SFBdragon/eee4113f-project/enclosure_subsystem/Media/Images/Sunken_SharcBuoy.JPG

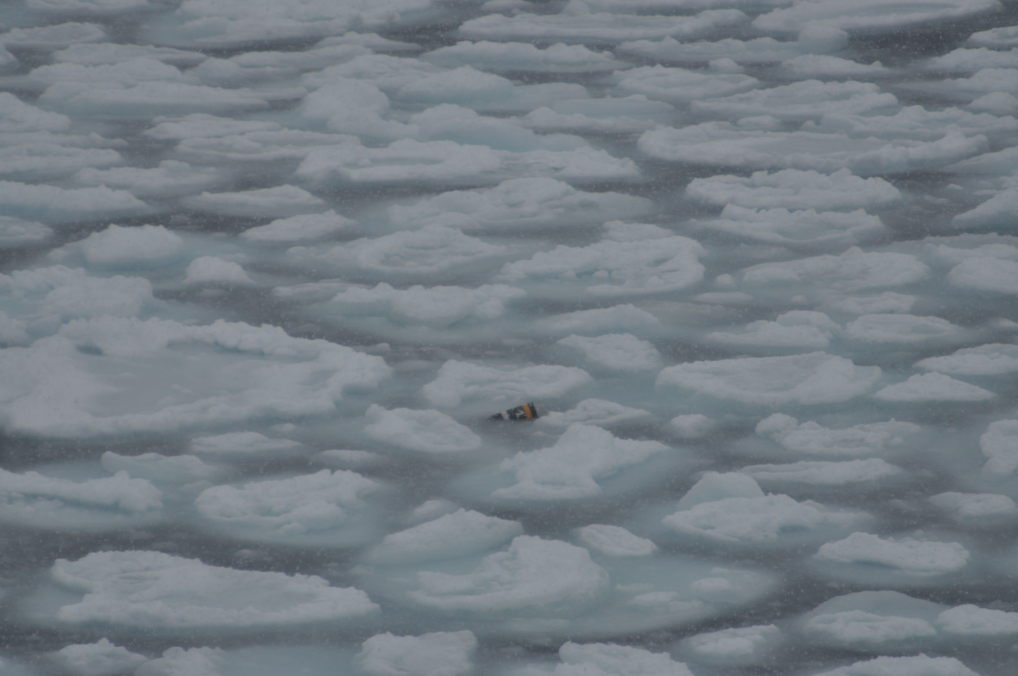
enclosure_subsystem/Media/Images/Sunken_SharcBuoy.JPG
