SFBdragon/eee4113f-project/enclosure_subsystem/Media/Images/20220717_UniversityofGottenburg_sailbuoy_retrival.jpeg

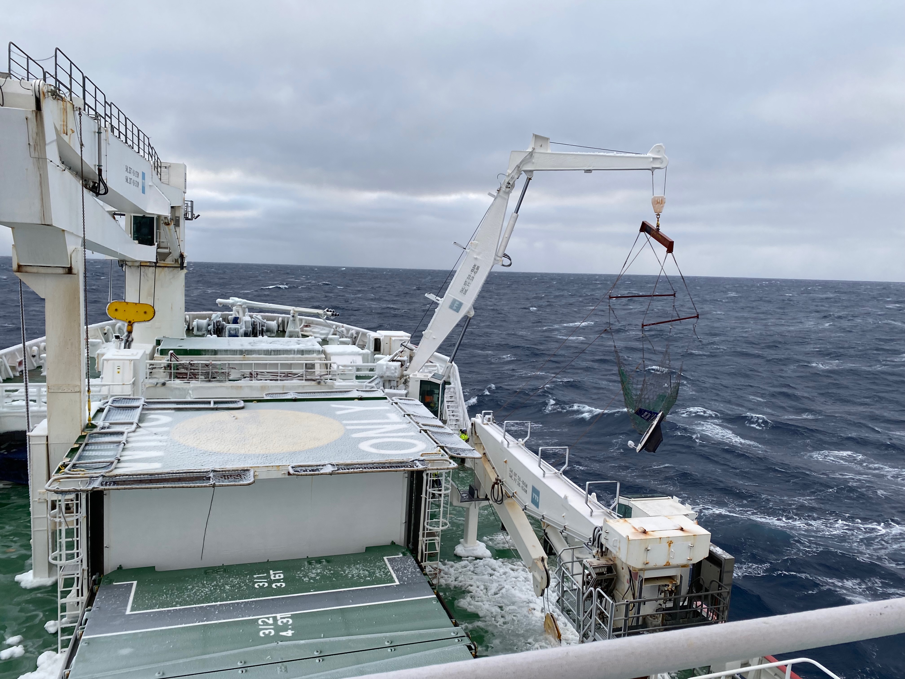
enclosure_subsystem/Media/Images/20220717_UniversityofGottenburg_sailbuoy_retrival.jpeg
