SFBdragon/eee4113f-project/README.md

# EEE4113F Project - Antarctic Measurement System Communication Module

_Group 5_

---

TODO
