SFBdragon/eee4113f-project/enclosure_subsystem/Data_Logs/readme_sb01.md

# SHARC Buoy SB01 Notes

## Buoy Information
| Parameter | Details |
|---|---|
| **Buoy Name** | SB01 |
| **Model** | SHARC Buoy Version 3.0 |
| **Firmware Version** | Version 18 July 2022 |  
| **Sampling rate** | 103 Hz |
| **Sampling interval** | 25 minutes (5*5 minute) |
| **Onboard storage** | Raw inertial time series, time and GNSS data. |
| **Transmission interval**  | ~42 minutes |
| **Transmission packet** | GNSS position, time, excludes wave statistics |
| **Iridium RockBlock Code** | CNH-GUD |
| **Iridium Code (Serial)**  | 205042 |
| **Iridium Code (IMEI)** | 300434061062220 |
| **IMU Number** | TEST (T) IMU |
| **SD Card Number** | SD1 |
---
## Deployment

| Parameter | Value |
|---|---|
| **Station Name** | ICE21 (I1) | 
| **Date** | 2022-07-19 |
| **Station time open (UTC)**  | 12:35 |
| **Station time closed (UTC)**| 16:17 |
| **Time deployed (UTC)** | 13:20 |
| **Coordinates (DD)** | -58.67003, -1.24678 |
| **Coordinates (DMS)** | 58°40'12.11"S, 1°14'48.41"W  |
| **Sounding (m)** | 4216.0 |
| **Humidity (%)** | 86 |
| **Barometer** | 0.9947 |
| **Air Temperature (°C)** | -7.5 |
| **Wind Speed (kn) rel** | 11.3 |
| **Wind Speed (kn) tue** | 12.3 |
| **Wind Direction rel (deg)** | 215 |
| **Wind Direction true (deg)**| 264.5 |

### Deployment Team
- **Member 1:** Michael Noyce
- **Member 2:** Justin Pead
- **Member 3:** Robyn Verrinder
  
### Deployment image
SB01 Deployment on 2022-07-19. Image credit: A Spirakis

### Additional Notes
- Deployed successfully onto consolidated ice with fresh snow layer using personnel basket from front overside crane. Calm conditions
- Ice floe strong enough for standing and buoy stand placed on ice by hand.
- Only SHARC2 GoPro Hero10 camera footage recorded successfully; SHARC1 failed.

---
	
## Retrieval
| Parameter | Value |
|---|---|
| **Station Name:** | SB01 |
| **Date** | 2022-07-24 |
| **Station time open (UTC)**  | 12:08 |
| **Station time closed (UTC)**| 12:30 |
| **Time retrived (UTC)** | 12:25 |
| **Coordinates (DD)** | -59.1141, 0.66428 |
| **Coordinates (DMS)** | 59°6'50.76"S, 0°39'51.41"E |
| **Sounding (m)** | 4730.7 |
| **Humidity (%)** | 84 |
| **Barometer** | 0.958 |
| **Air Temperature (°C)** | -2.2 |
| **Wind Speed (kn) rel** | 13 |
| **Wind Speed (kn) tue** | 12.9 |
| **Wind Direction rel (deg)** | 57.4 |
| **Wind Direction true (deg)**| 318.7 |

### Retrieval Team
- **Member 1:** Michael Noyce
- **Member 2:** Lawrence Stanton
- **Member 3:** Safiyyah Moos

### Retrieval image
SB01 Retrieval on 2022-07-24. Image credit: N Taylor

### Additional Notes
- Ice floe size significantly reduced, melted, and broke apart;
- Buoy stand sank and buoy temporarily submerged during retrieval but collected and data retrieved.
- No camera footage recorded on GoPro Hero10 cameras (SHARC1 and SHARC2).
- Still images of conditions obtained from N Taylor

### Buoy Condition
- Power board disconnected after system disconnected.
- Condensation on exterior of seal and bottom PCB.
- Corrosion observed on power board lead solder pads and Iridium stand solder pads.
- Batteries ignited as they got wet during the retrieval
- **Cause:** AfriSol solder wire is susceptible to corrosion.
- **Battery voltage:** 7.195 V
