SFBdragon/eee4113f-project/enclosure_subsystem/Media/Images/20220720_GoPRO_SHARC2_SB04_deployment.png

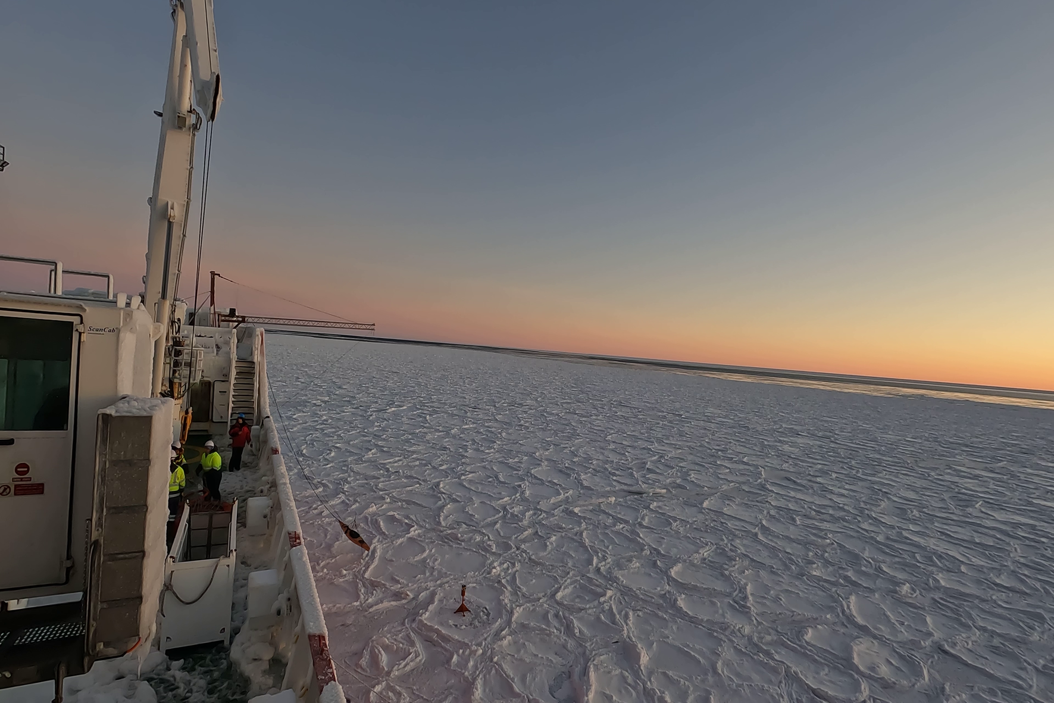
enclosure_subsystem/Media/Images/20220720_GoPRO_SHARC2_SB04_deployment.png
