SFBdragon/eee4113f-project/enclosure_subsystem/Media/Images/20220724_GoPRO_SHARC1_SB04_retrieval.png

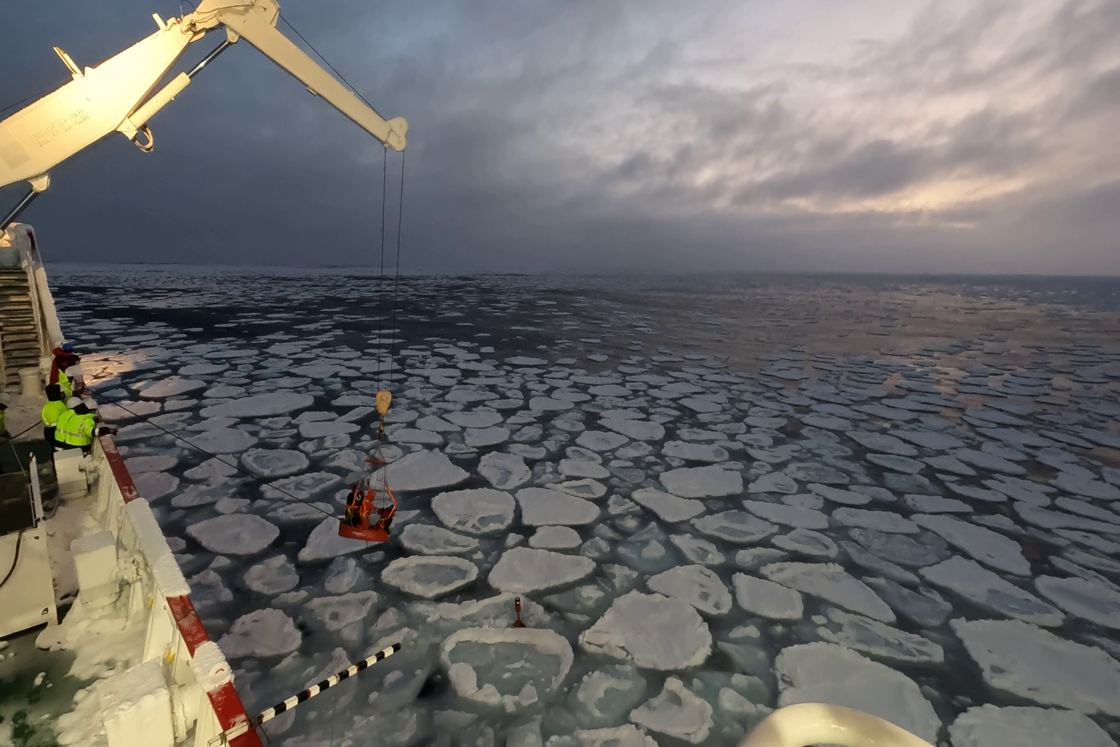
enclosure_subsystem/Media/Images/20220724_GoPRO_SHARC1_SB04_retrieval.png
