SFBdragon/eee4113f-project/enclosure_subsystem/Media/Images/20220724_SB01_02_Taylor_N.JPG

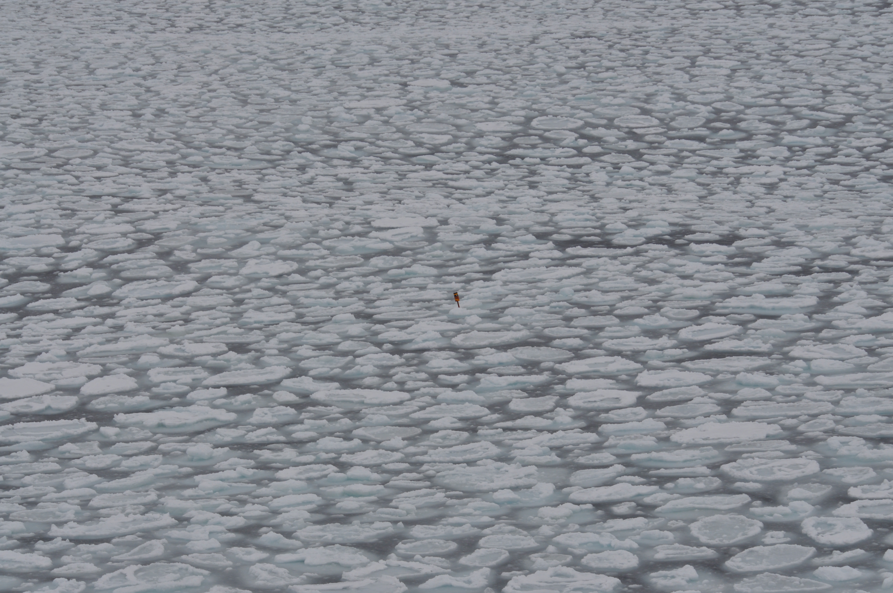
enclosure_subsystem/Media/Images/20220724_SB01_02_Taylor_N.JPG
