SFBdragon/eee4113f-project/enclosure_subsystem/Model_Files/floatation_Ring.stl

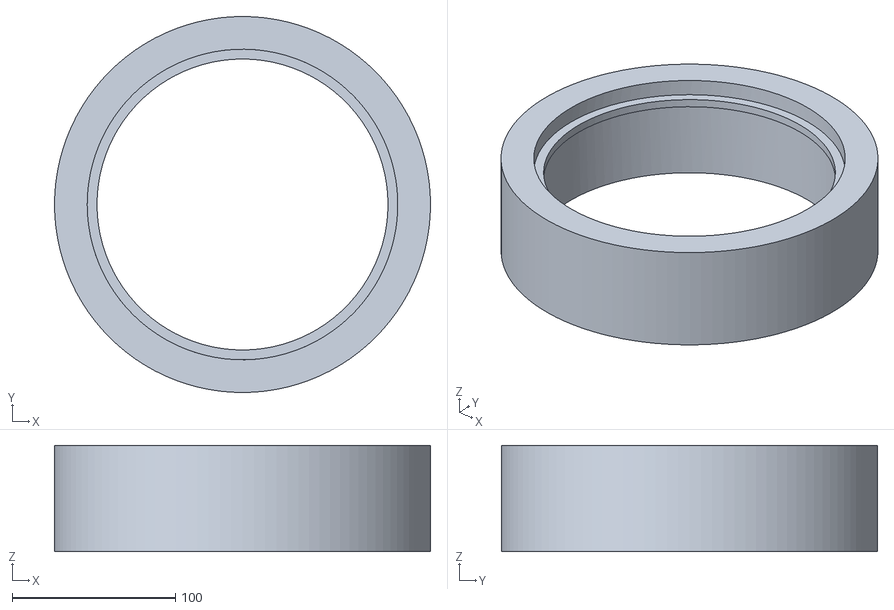
[picture p7: CAD file, 2026-05-19]
enclosure_subsystem/Model_Files/floatation_Ring.stl
230.0 x 230.0 x 65.0
