SFBdragon/eee4113f-project/enclosure_subsystem/Model_Files/ballast_body.stl

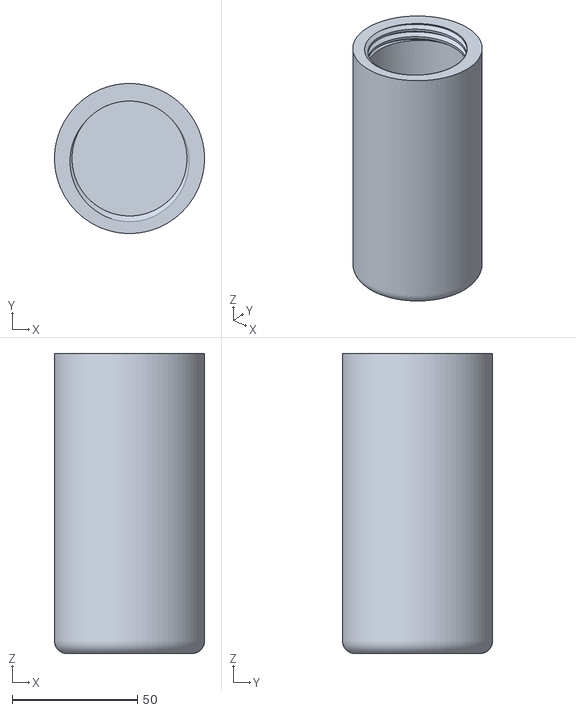
[picture p8: CAD file, 2026-05-19]
enclosure_subsystem/Model_Files/ballast_body.stl
60.0 x 60.0 x 120.0
