SFBdragon/eee4113f-project/enclosure_subsystem/Model_Files/component_holder.stl

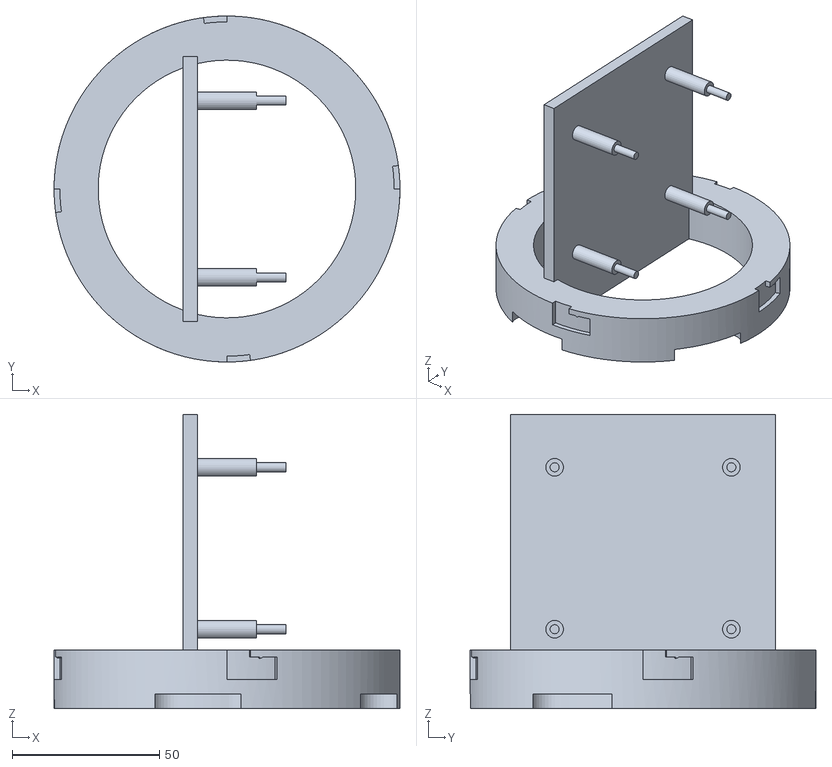
[picture p9: CAD file, 2026-05-19]
enclosure_subsystem/Model_Files/component_holder.stl
117.5 x 117.5 x 100.0
