SFBdragon/eee4113f-project/enclosure_subsystem/Model_Files/connector_pod.stl

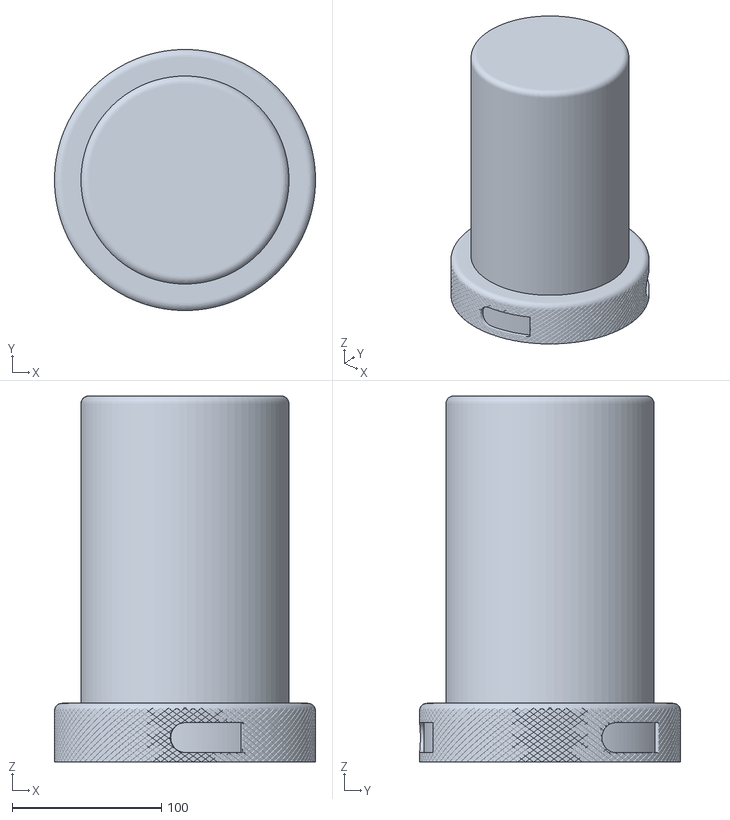
[picture p10: CAD file, 2026-05-19]
enclosure_subsystem/Model_Files/connector_pod.stl
175.0 x 175.0 x 245.4
