SFBdragon/eee4113f-project/enclosure_subsystem/Model_Files/sb_cover.stl

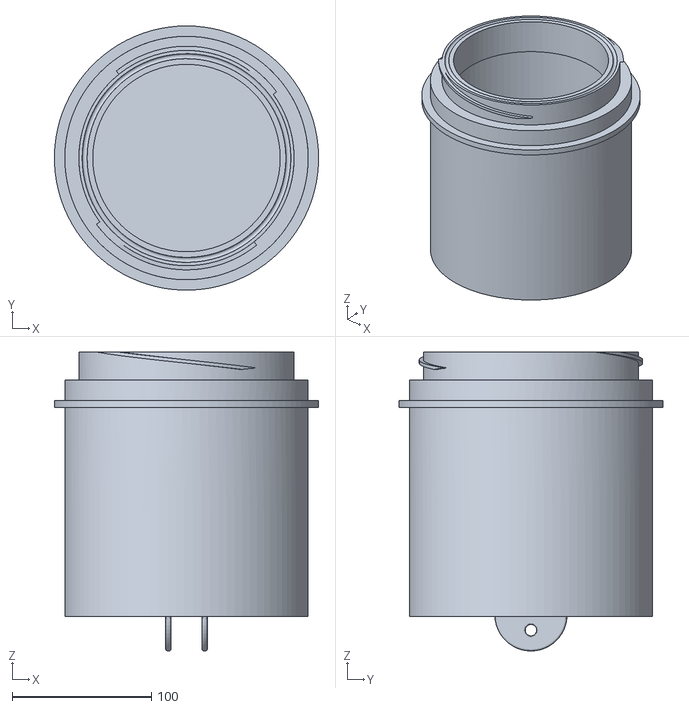
[picture p11: CAD file, 2026-05-19]
enclosure_subsystem/Model_Files/sb_cover.stl
190.0 x 189.9 x 215.0
