SFBdragon/eee4113f-project/enclosure_subsystem/Model_Files/ballast_lid.stl

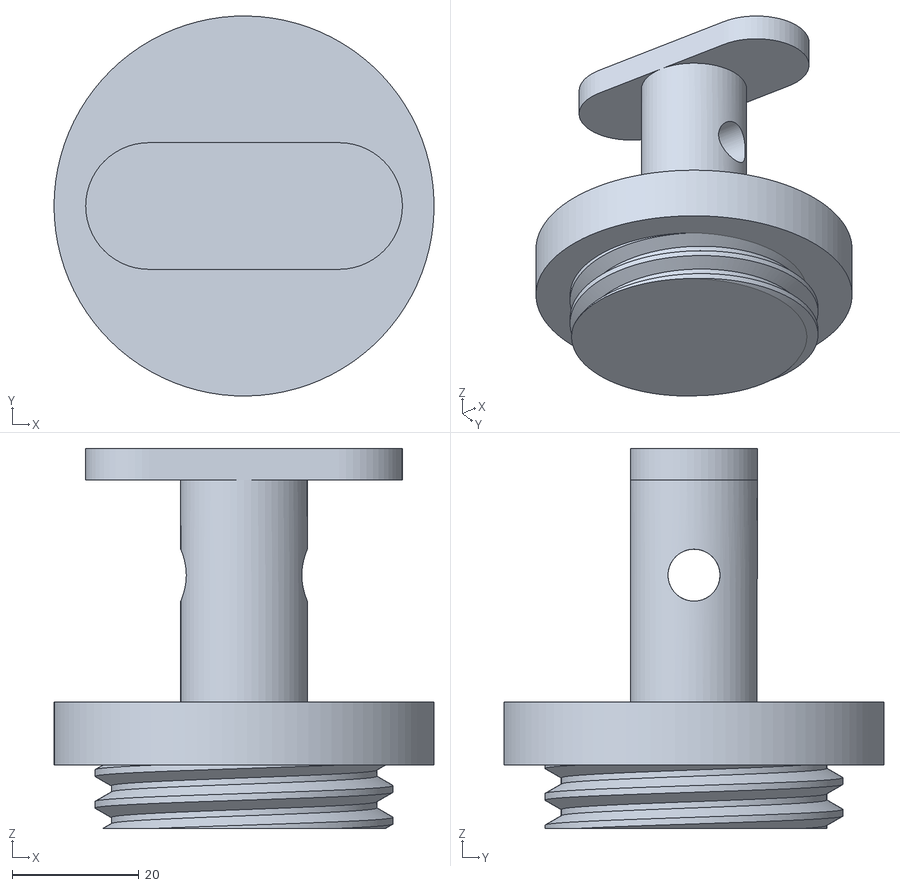
[picture p12: CAD file, 2026-05-19]
enclosure_subsystem/Model_Files/ballast_lid.stl
60.0 x 60.0 x 60.0
