SFBdragon/eee4113f-project/enclosure_subsystem/Model_Files/ballast_nut.stl

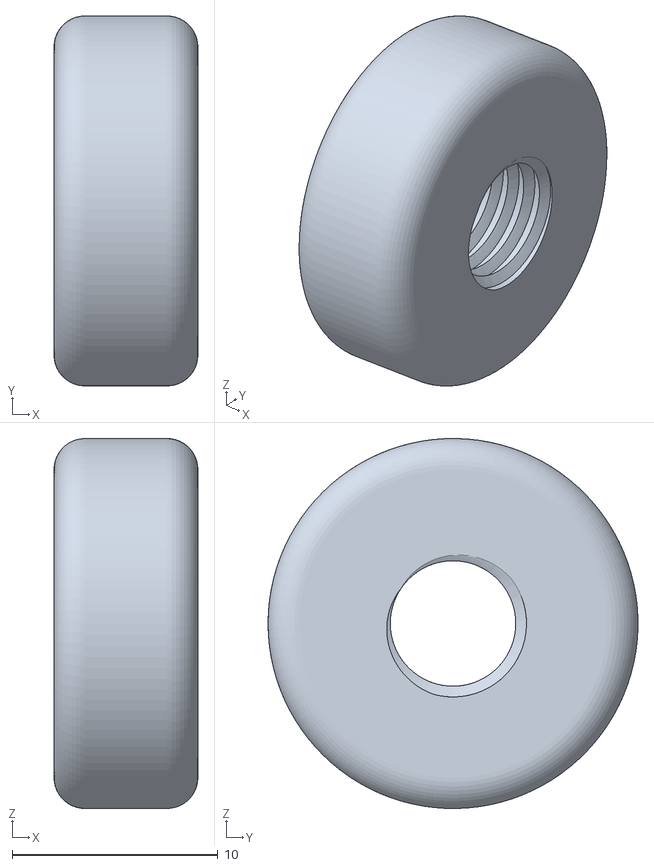
[picture p13: CAD file, 2026-05-19]
enclosure_subsystem/Model_Files/ballast_nut.stl
7.00 x 18.0 x 18.0
