SFBdragon/eee4113f-project/enclosure_subsystem/Model_Files/ballast_screw.stl

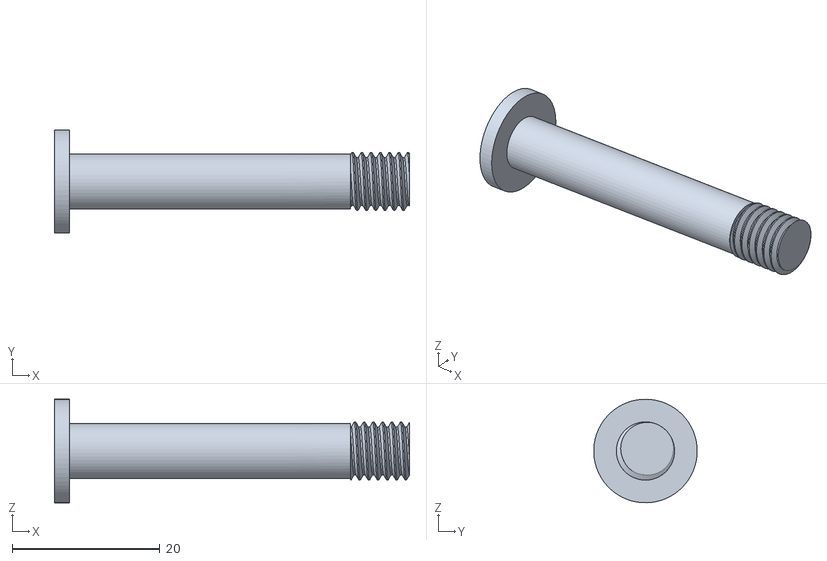
[picture p14: CAD file, 2026-05-19]
enclosure_subsystem/Model_Files/ballast_screw.stl
48.0 x 14.0 x 14.0
