SFBdragon/eee4113f-project/laptop-drivers/RF_ATPs/test100m.csv

timestamp | packet_num | payload | rssi_dbm | snr_db | len_bytes
2026-05-13T14:11:39 | 1 | 1 | -75 | 6 | 1
2026-05-13T14:11:41 | 2 | 2 | -75 | 6 | 1
2026-05-13T14:11:43 | 3 | 3 | -75 | 5 | 1
2026-05-13T14:11:45 | 4 | 4 | -75 | 4 | 1
2026-05-13T14:11:47 | 5 | 5 | -75 | 5 | 1
2026-05-13T14:11:49 | 6 | 6 | -74 | 6 | 1
2026-05-13T14:11:51 | 7 | 7 | -74 | 6 | 1
2026-05-13T14:11:53 | 8 | 8 | -74 | 6 | 1
2026-05-13T14:11:55 | 9 | 9 | -74 | 6 | 1
2026-05-13T14:11:57 | 10 | 10 | -76 | 5 | 2
2026-05-13T14:11:59 | 11 | 11 | -76 | 6 | 2
2026-05-13T14:12:01 | 12 | 12 | -75 | 6 | 2
2026-05-13T14:12:03 | 13 | 13 | -75 | 6 | 2
2026-05-13T14:12:05 | 14 | 14 | -75 | 5 | 2
2026-05-13T14:12:07 | 15 | 15 | -75 | 6 | 2
2026-05-13T14:12:09 | 16 | 16 | -75 | 6 | 2
2026-05-13T14:12:11 | 17 | 17 | -76 | 5 | 2
2026-05-13T14:12:13 | 18 | 18 | -75 | 6 | 2
2026-05-13T14:12:15 | 19 | 19 | -76 | 5 | 2
2026-05-13T14:12:17 | 20 | 20 | -76 | 6 | 2
2026-05-13T14:12:19 | 21 | 21 | -76 | 7 | 2
2026-05-13T14:12:21 | 22 | 22 | -75 | 5 | 2
2026-05-13T14:12:23 | 23 | 23 | -75 | 6 | 2
2026-05-13T14:12:25 | 24 | 24 | -74 | 6 | 2
2026-05-13T14:12:27 | 25 | 25 | -75 | 7 | 2
2026-05-13T14:12:29 | 26 | 26 | -75 | 5 | 2
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
