SFBdragon/eee4113f-project/laptop-drivers/RF_ATPs/test10m.csv

timestamp | packet_num | payload | rssi_dbm | snr_db | len_bytes
2026-05-13T14:04:37 | 1 | 3 | -51 | 6 | 1
2026-05-13T14:04:39 | 2 | 4 | -49 | 5 | 1
2026-05-13T14:04:41 | 3 | 5 | -52 | 6 | 1
2026-05-13T14:04:43 | 4 | 6 | -49 | 7 | 1
2026-05-13T14:04:45 | 5 | 7 | -51 | 6 | 1
2026-05-13T14:04:47 | 6 | 8 | -51 | 6 | 1
2026-05-13T14:04:49 | 7 | 9 | -50 | 6 | 1
2026-05-13T14:04:51 | 8 | 10 | -51 | 5 | 2
2026-05-13T14:04:53 | 9 | 11 | -51 | 7 | 2
2026-05-13T14:04:55 | 10 | 12 | -51 | 6 | 2
2026-05-13T14:04:57 | 11 | 13 | -56 | 5 | 2
2026-05-13T14:04:59 | 12 | 14 | -54 | 6 | 2
2026-05-13T14:05:01 | 13 | 15 | -54 | 6 | 2
2026-05-13T14:05:03 | 14 | 16 | -51 | 6 | 2
2026-05-13T14:05:05 | 15 | 17 | -51 | 6 | 2
2026-05-13T14:05:07 | 16 | 18 | -51 | 6 | 2
2026-05-13T14:05:09 | 17 | 19 | -51 | 6 | 2
2026-05-13T14:05:11 | 18 | 20 | -50 | 7 | 2
2026-05-13T14:05:13 | 19 | 21 | -53 | 7 | 2
2026-05-13T14:05:15 | 20 | 22 | -54 | 6 | 2
2026-05-13T14:05:17 | 21 | 23 | -52 | 6 | 2
2026-05-13T14:05:19 | 22 | 24 | -53 | 6 | 2
2026-05-13T14:05:21 | 23 | 25 | -54 | 7 | 2
2026-05-13T14:05:23 | 24 | 26 | -68 | 6 | 2
2026-05-13T14:05:25 | 25 | 27 | -61 | 6 | 2
2026-05-13T14:05:27 | 26 | 28 | -56 | 6 | 2
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
