SFBdragon/eee4113f-project/laptop-drivers/RF_ATPs/test200m.csv

timestamp | packet_num | payload | rssi_dbm | snr_db | len_bytes
2026-05-13T14:18:54 | 1 | 1 | -91 | -13 | 1
2026-05-13T14:18:56 | 2 | 2 | -96 | 1 | 1
2026-05-13T14:18:58 | 3 | 3 | -88 | -4 | 1
2026-05-13T14:19:02 | 4 | 5 | -90 | -4 | 1
2026-05-13T14:19:04 | 5 | 6 | -92 | -2 | 1
2026-05-13T14:19:06 | 6 | 7 | -94 | 2 | 1
2026-05-13T14:19:08 | 7 | 8 | -88 | -8 | 1
2026-05-13T14:19:10 | 8 | 9 | -87 | -10 | 1
2026-05-13T14:19:12 | 9 | 10 | -86 | -8 | 2
2026-05-13T14:19:14 | 10 | 11 | -88 | -6 | 2
2026-05-13T14:19:16 | 11 | 12 | -96 | 0 | 2
2026-05-13T14:19:18 | 12 | 13 | -85 | -12 | 2
2026-05-13T14:19:20 | 13 | 14 | -88 | -11 | 2
2026-05-13T14:19:22 | 14 | 15 | -86 | -12 | 2
2026-05-13T14:19:24 | 15 | 16 | -96 | -5 | 2
2026-05-13T14:19:26 | 16 | 17 | -87 | -4 | 2
2026-05-13T14:19:28 | 17 | 18 | -82 | -13 | 2
2026-05-13T14:19:30 | 18 | 19 | -86 | -15 | 2
2026-05-13T14:19:32 | 19 | 20 | -85 | -13 | 2
2026-05-13T14:19:34 | 20 | 21 | -96 | 1 | 2
2026-05-13T14:19:36 | 21 | 22 | -85 | -13 | 2
2026-05-13T14:19:38 | 22 | 23 | -84 | -12 | 2
2026-05-13T14:19:40 | 23 | 24 | -84 | -9 | 2
2026-05-13T14:19:42 | 24 | 25 | -83 | -11 | 2
2026-05-13T14:19:44 | 25 | 26 | -92 | 3 | 2
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
