SFBdragon/eee4113f-project/laptop-drivers/RF_ATPs/test202m.csv

timestamp | packet_num | payload | rssi_dbm | snr_db | len_bytes
2026-05-15T12:41:27 | 1 | 1 | -92 | 2 | 1
2026-05-15T12:41:29 | 2 | 2 | -89 | -6 | 1
2026-05-15T12:41:31 | 3 | 3 | -90 | -3 | 1
2026-05-15T12:41:33 | 4 | 4 | -76 | 5 | 1
2026-05-15T12:41:35 | 5 | 5 | -78 | 5 | 1
2026-05-15T12:41:37 | 6 | 6 | -78 | 5 | 1
2026-05-15T12:41:39 | 7 | 7 | -79 | 4 | 1
2026-05-15T12:41:41 | 8 | 8 | -78 | 5 | 1
2026-05-15T12:41:43 | 9 | 9 | -78 | 5 | 1
2026-05-15T12:41:45 | 10 | 10 | -78 | 4 | 2
2026-05-15T12:41:47 | 11 | 11 | -78 | 5 | 2
2026-05-15T12:41:49 | 12 | 12 | -78 | 3 | 2
2026-05-15T12:41:51 | 13 | 13 | -77 | 6 | 2
2026-05-15T12:41:53 | 14 | 14 | -78 | 5 | 2
2026-05-15T12:41:55 | 15 | 15 | -79 | 5 | 2
2026-05-15T12:41:57 | 16 | 16 | -78 | 5 | 2
2026-05-15T12:41:59 | 17 | 17 | -77 | 6 | 2
2026-05-15T12:42:01 | 18 | 18 | -78 | 5 | 2
2026-05-15T12:42:03 | 19 | 19 | -82 | 2 | 2
2026-05-15T12:42:05 | 20 | 20 | -78 | 5 | 2
2026-05-15T12:42:07 | 21 | 21 | -82 | 4 | 2
2026-05-15T12:42:09 | 22 | 22 | -80 | 4 | 2
2026-05-15T12:42:11 | 23 | 23 | -81 | 4 | 2
2026-05-15T12:42:13 | 24 | 24 | -81 | 4 | 2
2026-05-15T12:42:15 | 25 | 25 | -80 | 4 | 2
2026-05-15T12:42:17 | 26 | 26 | -81 | 4 | 2
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
