SFBdragon/eee4113f-project/laptop-drivers/RF_ATPs/test_lora_2km_01m.csv

timestamp | packet_num | payload | rssi_dbm | snr_db | len_bytes
2026-05-15T13:20:09 | 1 | 1 | -86 | -16 | 1
2026-05-15T13:20:11 | 2 | 2 | -89 | -11 | 1
2026-05-15T13:20:13 | 3 | 3 | -85 | -15 | 1
2026-05-15T13:20:17 | 4 | 5 | -90 | -9 | 1
2026-05-15T13:20:19 | 5 | 6 | -87 | -11 | 1
2026-05-15T13:20:21 | 6 | 7 | -91 | -8 | 1
2026-05-15T13:20:23 | 7 | 8 | -92 | -6 | 1
2026-05-15T13:20:25 | 8 | 9 | -91 | -8 | 1
2026-05-15T13:20:27 | 9 | 10 | -90 | -8 | 2
2026-05-15T13:20:29 | 10 | 11 | -90 | -10 | 2
2026-05-15T13:20:31 | 11 | 12 | -92 | -6 | 2
2026-05-15T13:20:33 | 12 | 13 | -93 | -6 | 2
2026-05-15T13:20:35 | 13 | 14 | -93 | -6 | 2
2026-05-15T13:20:37 | 14 | 15 | -92 | -6 | 2
2026-05-15T13:20:39 | 15 | 16 | -92 | -6 | 2
2026-05-15T13:20:41 | 16 | 17 | -92 | -5 | 2
2026-05-15T13:20:43 | 17 | 18 | -93 | -8 | 2
2026-05-15T13:20:45 | 18 | 19 | -91 | -5 | 2
2026-05-15T13:20:47 | 19 | 20 | -92 | -6 | 2
2026-05-15T13:20:49 | 20 | 21 | -92 | -6 | 2
2026-05-15T13:20:51 | 21 | 22 | -92 | -4 | 2
2026-05-15T13:20:53 | 22 | 23 | -91 | -4 | 2
2026-05-15T13:20:55 | 23 | 24 | -91 | -6 | 2
2026-05-15T13:20:57 | 24 | 25 | -91 | -5 | 2
2026-05-15T13:20:59 | 25 | 26 | -91 | -4 | 2
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
