SFBdragon/eee4113f-project/PCB Files/ComsBoard.kicad_pcb

## KiCad design PCB Files/ComsBoard.kicad_pcb (2026-05-22)

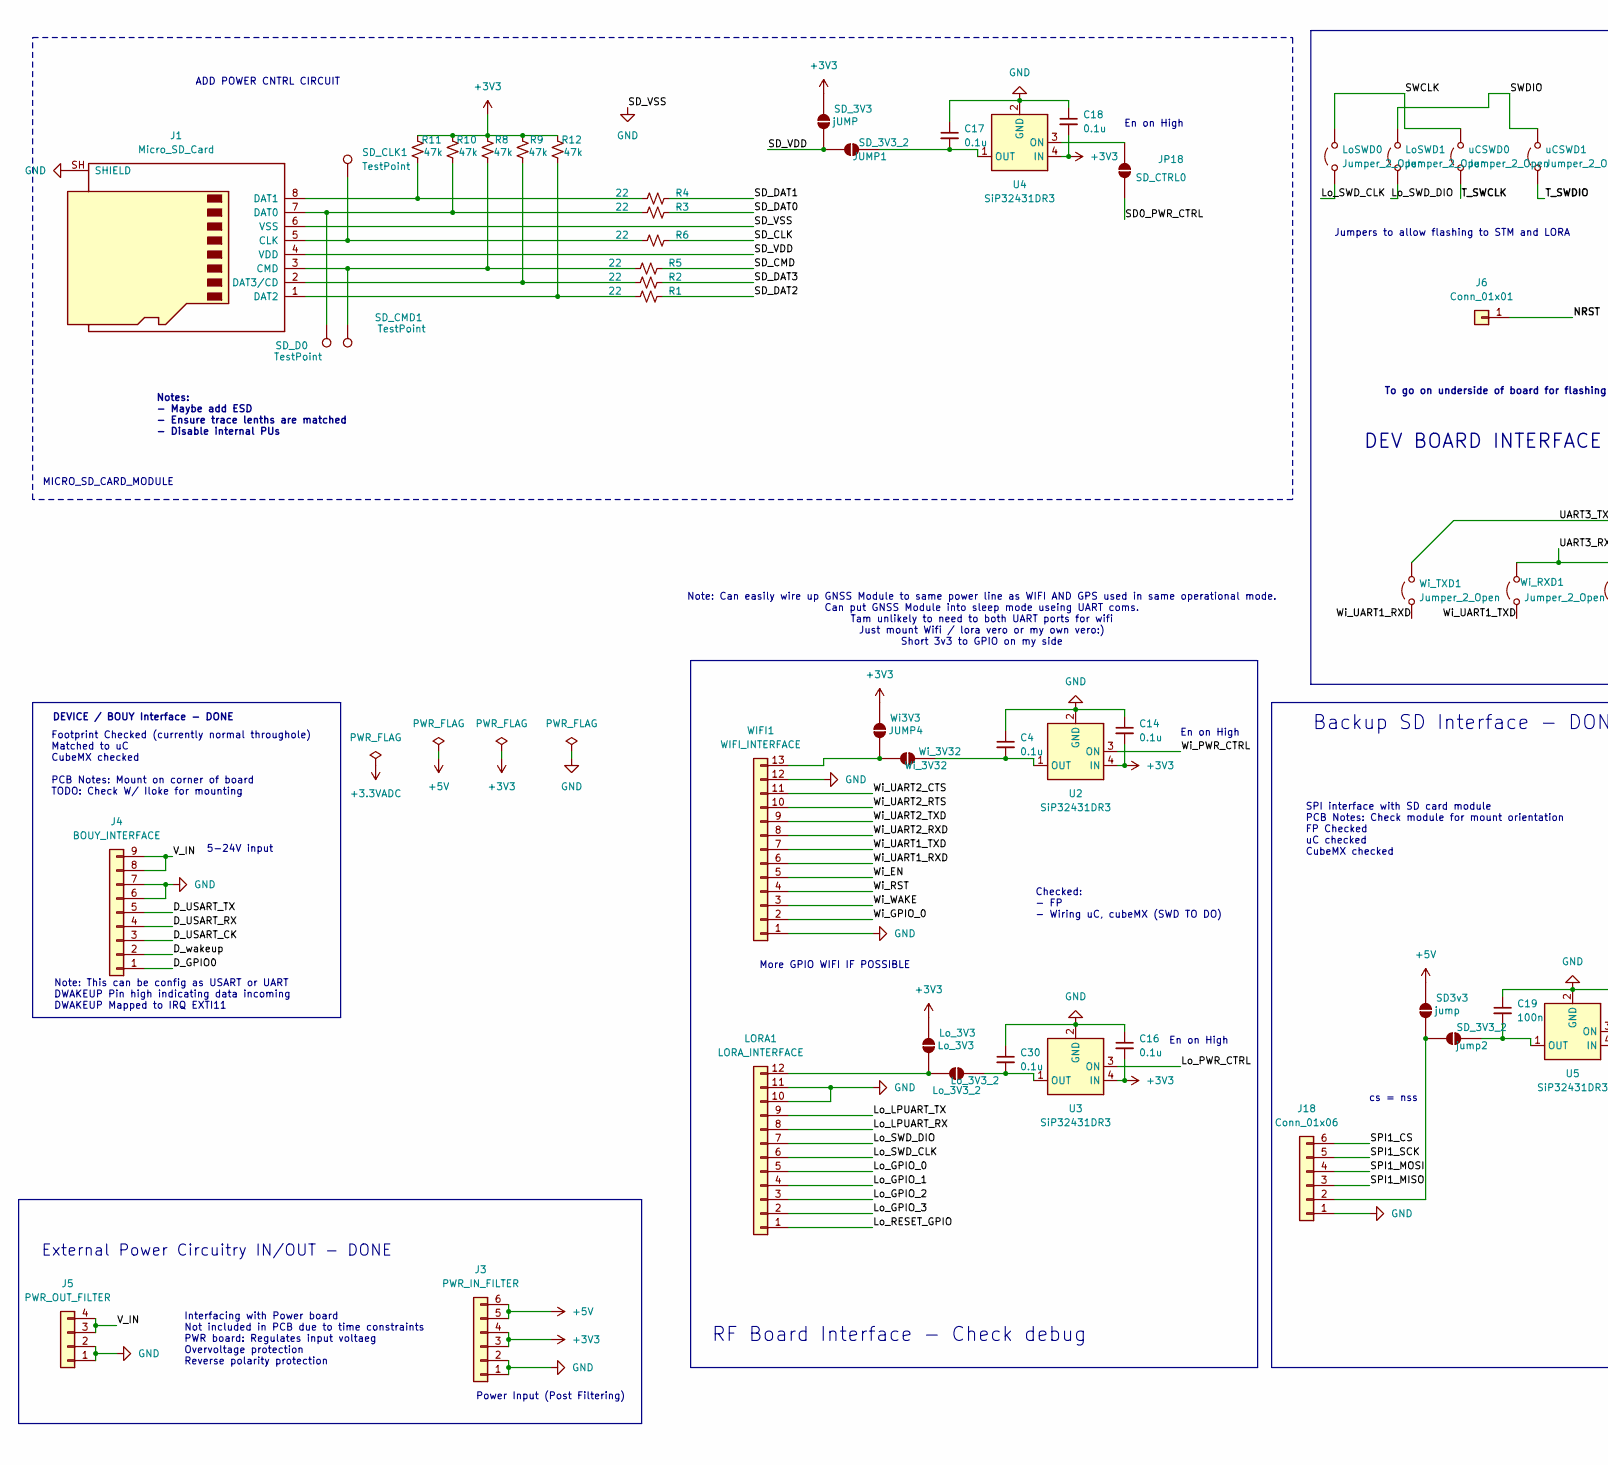
[picture p15: schematic ComsBoard.kicad_sch, EEE4114F, part in row 1, column 1]

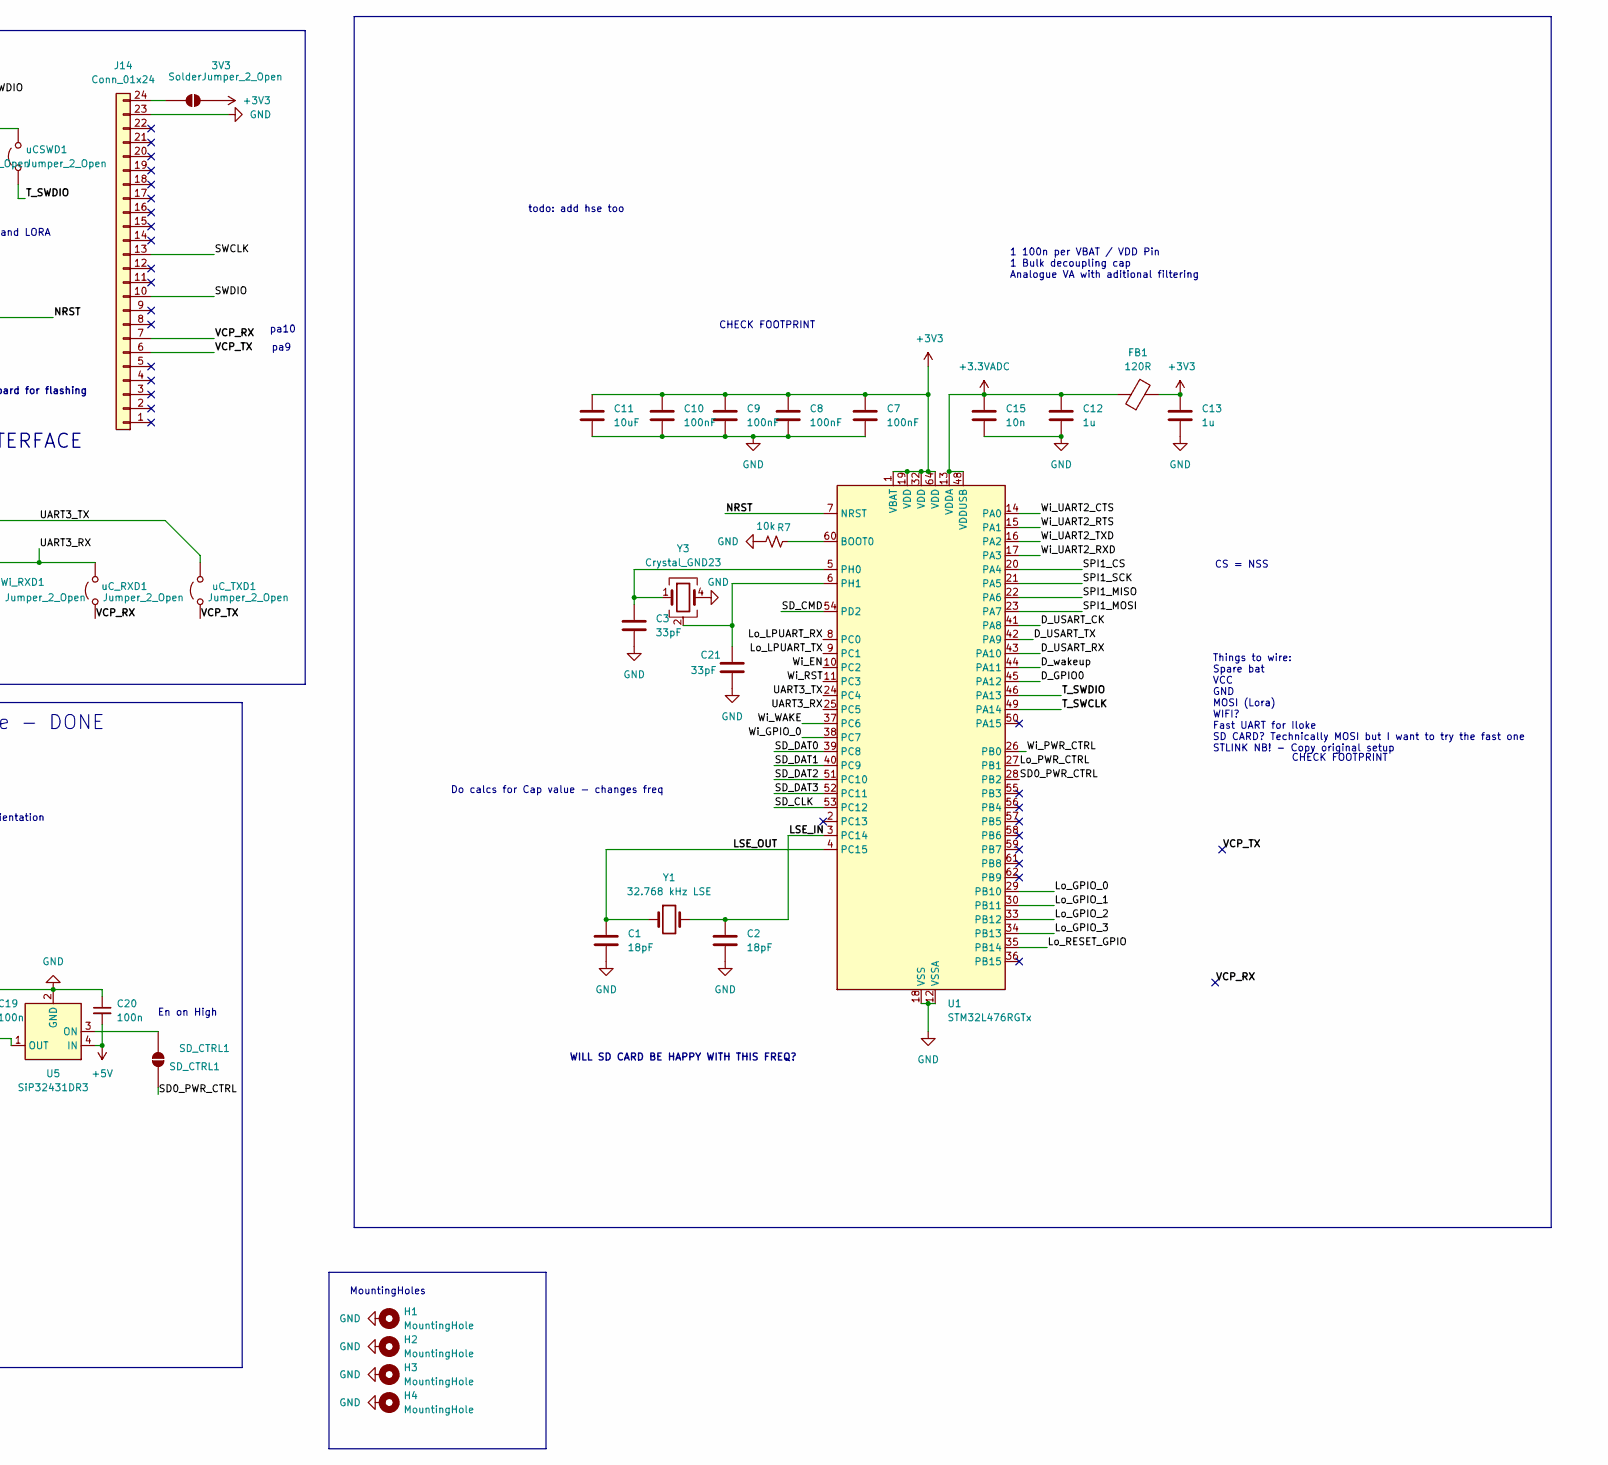
[picture p16: schematic ComsBoard.kicad_sch, EEE4114F, part in row 1, column 2]

Parts:
3V3: SolderJumper_2_Open; SolderJumper-2_P1.3mm_Open_RoundedPad1.0x1.5mm
C1, C2: 18pF; C_0603_1608Metric
C3, C21: 33pF; C_0603_1608Metric
C4, C14, C16, C17, C18, C30: 0.1u; C_0603_1608Metric
C7, C8, C9, C10: 100nF; C_0603_1608Metric
C11: 10uF; C_0603_1608Metric
C12, C13: 1u; C_0603_1608Metric
C15: 10n; C_0603_1608Metric
C19, C20: 100n; C_0603_1608Metric
FB1: 120R; L_0603_1608Metric
H1, H2, H3, H4: MountingHole; MountingHole_3.2mm_M3_DIN965_Pad
J1: Micro_SD_Card; microSD_HC_Molex_47219-2001
J3: PWR_IN_FILTER; PinHeader_1x06_P2.54mm_Vertical
J4: BOUY_INTERFACE; PinHeader_1x09_P2.54mm_Vertical
J5: PWR_OUT_FILTER; PinHeader_1x04_P2.54mm_Vertical
J6: Conn_01x01; PinSocket_1x01_P2.54mm_Vertical
J14: Conn_01x24; PinSocket_1x24_P2.54mm_Vertical
J18: Conn_01x06; PinHeader_1x06_P2.54mm_Vertical
JP18: SD_CTRL0; SolderJumper-2_P1.3mm_Open_RoundedPad1.0x1.5mm
JUMP1: SD_3V3_2; SolderJumper-2_P1.3mm_Open_RoundedPad1.0x1.5mm
LORA1: LORA_INTERFACE; PinHeader_1x12_P2.54mm_Vertical
LoSWD0, LoSWD1: Jumper_2_Open; PinSocket_1x02_P2.54mm_Vertical
Lo_3V3: Lo_3V3; SolderJumper-2_P1.3mm_Open_RoundedPad1.0x1.5mm
Lo_3V3_2: Lo_3V3_2; SolderJumper-2_P1.3mm_Open_RoundedPad1.0x1.5mm
R1, R2, R3, R4, R5, R6: 22; R_0603_1608Metric
R7: 10k; R_0603_1608Metric
R8, R9, R10, R11, R12: 47k; R_0603_1608Metric
SD3v3: jump; SolderJumper-2_P1.3mm_Open_RoundedPad1.0x1.5mm
SD_3V3: jUMP; SolderJumper-2_P1.3mm_Open_RoundedPad1.0x1.5mm
SD_CLK1: TestPoint; TestPoint_Pad_D1.5mm
SD_CMD1: TestPoint; TestPoint_Pad_D1.5mm
SD_CTRL1: SD_CTRL1; SolderJumper-2_P1.3mm_Open_RoundedPad1.0x1.5mm
SD_D0: TestPoint; TestPoint_Pad_D1.5mm
U1: STM32L476RGTx; LQFP-64_10x10mm_P0.5mm
U2, U3, U4, U5: SiP32431DR3; SOT-363_SC-70-6
WIFI1: WIFI_INTERFACE; PinSocket_1x13_P2.54mm_Vertical
Wi3V3: JUMP4; SolderJumper-2_P1.3mm_Open_RoundedPad1.0x1.5mm
Wi_3V32: Wi_3V32; SolderJumper-2_P1.3mm_Open_RoundedPad1.0x1.5mm
Wi_RXD1: Jumper_2_Open; PinSocket_1x02_P2.54mm_Vertical
Wi_TXD1: Jumper_2_Open; PinSocket_1x02_P2.54mm_Vertical
Y1: 32.768 kHz LSE; Crystal_SMD_3215-2Pin_3.2x1.5mm
Y3: Crystal_GND23; Crystal_SMD_3225-4Pin_3.2x2.5mm
jump2: SD_3V3_2; SolderJumper-2_P1.3mm_Open_RoundedPad1.0x1.5mm
uCSWD0, uCSWD1: Jumper_2_Open; PinSocket_1x02_P2.54mm_Vertical
uC_RXD1: Jumper_2_Open; PinSocket_1x02_P2.54mm_Vertical
uC_TXD1: Jumper_2_Open; PinSocket_1x02_P2.54mm_Vertical

Connections:
+3.3VADC: C12.1, C15.1, FB1.1, U1.13 (VDDA), U1.48 (VDDUSB)
+5V: C20.2, J3.5, J3.6, SD3v3.2 (B), U5.4 (IN)
/D_GPIO0: J4.1, U1.45 (PA12)
/D_USART_CK: J4.3, U1.41 (PA8)
/D_USART_RX: J4.4, U1.43 (PA10)
/D_USART_TX: J4.5, U1.42 (PA9)
/D_wakeup: J4.2, U1.44 (PA11)
/LSE_IN: C2.1, U1.3 (PC14), Y1.2
/LSE_OUT: C1.1, U1.4 (PC15), Y1.1
/Lo_GPIO_0: LORA1.5, U1.29 (PB10)
/Lo_GPIO_1: LORA1.4, U1.30 (PB11)
/Lo_GPIO_2: LORA1.3, U1.33 (PB12)
/Lo_GPIO_3: LORA1.2, U1.34 (PB13)
/Lo_LPUART_RX: LORA1.8, U1.8 (PC0)
/Lo_LPUART_TX: LORA1.9, U1.9 (PC1)
/Lo_PWR_CTRL: U1.27 (PB1), U3.3 (ON)
/Lo_RESET_GPIO: LORA1.1, U1.35 (PB14)
/Lo_SWD_CLK: LORA1.6, LoSWD0.1 (A)
/Lo_SWD_DIO: LORA1.7, LoSWD1.1 (A)
/NRST: J6.1 (Pin_1_1), U1.7 (NRST)
/SD0_PWR_CTRL: JP18.2 (B), SD_CTRL1.2 (B), U1.28 (PB2)
/SD_CLK: R6.2, U1.53 (PC12)
/SD_CMD: R5.2, U1.54 (PD2)
/SD_DAT0: R3.2, U1.39 (PC8)
/SD_DAT1: R4.2, U1.40 (PC9)
/SD_DAT2: R1.2, U1.51 (PC10)
/SD_DAT3: R2.2, U1.52 (PC11)
/SPI1_CS: J18.6, U1.20 (PA4)
/SPI1_MISO: J18.3, U1.22 (PA6)
/SPI1_MOSI: J18.4, U1.23 (PA7)
/SPI1_SCK: J18.5, U1.21 (PA5)
/SWCLK: J14.13, LoSWD0.2 (B), uCSWD0.2 (B)
/SWDIO: J14.10, LoSWD1.2 (B), uCSWD1.2 (B)
/T_SWCLK: U1.49 (PA14), uCSWD0.1 (A)
/T_SWDIO: U1.46 (PA13), uCSWD1.1 (A)
/UART3_RX: U1.25 (PC5), Wi_RXD1.2 (B), uC_RXD1.2 (B)
/UART3_TX: U1.24 (PC4), Wi_TXD1.2 (B), uC_TXD1.2 (B)
/VCP_RX: J14.7, uC_RXD1.1 (A)
/VCP_TX: J14.6, uC_TXD1.1 (A)
/V_IN: J4.8, J4.9, J5.3, J5.4
/Wi_EN: U1.10 (PC2), WIFI1.5
/Wi_GPIO_0: U1.38 (PC7), WIFI1.2
/Wi_PWR_CTRL: U1.26 (PB0), U2.3 (ON)
/Wi_RST: U1.11 (PC3), WIFI1.4
/Wi_UART1_RXD: WIFI1.6, Wi_TXD1.1 (A)
/Wi_UART1_TXD: WIFI1.7, Wi_RXD1.1 (A)
/Wi_UART2_CTS: U1.14 (PA0), WIFI1.11
/Wi_UART2_RTS: U1.15 (PA1), WIFI1.10
/Wi_UART2_RXD: U1.17 (PA3), WIFI1.8
/Wi_UART2_TXD: U1.16 (PA2), WIFI1.9
/Wi_WAKE: U1.37 (PC6), WIFI1.3
GND: C1.2, C2.2, C3.2, C4.1, C7.2, C8.2, C9.2, C10.2, C11.2, C12.2, C13.2, C14.1, C15.2, C16.1, C17.1, C18.1, C19.1, C20.1, C21.2, C30.1, J1.6 (VSS), J1.SH (SHIELD), J3.1, J3.2, J4.6, J4.7, J5.1, J5.2, J14.23, J18.1, LORA1.10, LORA1.11, R7.1, U1.12 (VSSA), U1.18 (VSS), U1.31 (VSS), U1.47 (VSS), U1.63 (VSS), U2.2 (GND), U2.5 (GND), U3.2 (GND), U3.5 (GND), U4.2 (GND), U4.5 (GND), U5.2 (GND), U5.5 (GND), WIFI1.1, WIFI1.12, Y3.4; also elsewhere on the board
unnamed: 3V3.1 (A), J14.24
unnamed: J1.5 (CLK), R6.1, SD_CLK1.1 (1_1)
unnamed: J1.3 (CMD), R5.1, R8.1, SD_CMD1.1 (1_1)
unnamed: J1.7 (DAT0), R3.1, R10.1, SD_D0.1 (1_1)
unnamed: J1.8 (DAT1), R4.1, R11.1
unnamed: J1.1 (DAT2), R1.1, R12.1
unnamed: J1.2 (DAT3/CD), R2.1, R9.1
unnamed: J18.2, SD3v3.1 (A), jump2.2 (B)
unnamed: JP18.1 (A), U4.3 (ON)
unnamed: C17.2, JUMP1.1 (A), U4.1 (OUT)
unnamed: LORA1.12, Lo_3V3.1 (A), Lo_3V3_2.2 (B)
unnamed: C30.2, Lo_3V3_2.1 (A), U3.1 (OUT)
unnamed: SD_CTRL1.1 (A), U5.3 (ON)
unnamed: R7.2, U1.60 (BOOT0)
unnamed: C3.1, U1.5 (PH0), Y3.1
unnamed: C21.1, U1.6 (PH1), Y3.2 (G), Y3.3 (G)
unnamed: C4.2, U2.1 (OUT), Wi_3V32.1 (A)
unnamed: C19.2, U5.1 (OUT), jump2.1 (A)
unnamed: WIFI1.13, Wi3V3.1 (A), Wi_3V32.2 (B)

Notes on the sheet:
Note: Can easily wire up GNSS Module to same power line as WIFI AND GPS used in same operational mode. Can put GNSS Module into sleep mode useing UART coms. Tam unlikely to need to both UART ports for wifi Just mount Wifi / lora vero or my own vero:) Short 3v3 to GPIO on my side
More GPIO WIFI IF POSSIBLE
CHECK FOOTPRINT
cs = nss
SPI interface with SD card module PCB Notes: Check module for mount orientation FP Checked uC checked CubeMX checked
Footprint Checked (currently normal throughole) Matched to uC CubeMX checked PCB Notes: Mount on corner of board TODO: Check W/ Iloke for mounting
En on High
RF Board Interface - Check debug
Note: This can be config as USART or UART DWAKEUP Pin high indicating data incoming DWAKEUP Mapped to IRQ EXTI11
Things to wire: Spare bat VCC GND MOSI (Lora) WIFI? Fast UART for Iloke SD CARD? Technically MOSI but I want to try the fast one STLINK NB! - Copy original setup
DEVICE / BOUY Interface - DONE
WILL SD CARD BE HAPPY WITH THIS FREQ?
pa9
Power Input (Post Filtering)
CS = NSS
Interfacing with Power board Not included in PCB due to time constraints PWR board: Regulates input voltaeg Overvoltage protection Reverse polarity protection
External Power Circuitry IN/OUT - DONE
Notes: - Maybe add ESD - Ensure trace lenths are matched - Disable internal PUs
todo: add hse too
To go on underside of board for flashing
Jumpers to allow flashing to STM and LORA
pa10
Checked: - FP - Wiring uC, cubeMX (SWD TO DO)
Backup SD Interface - DONE
DEV BOARD INTERFACE
ADD POWER CNTRL CIRCUIT
MICRO_SD_CARD_MODULE
1 100n per VBAT / VDD Pin 1 Bulk decoupling cap Analogue VA with aditional filtering
5-24V input
MountingHoles
Do calcs for Cap value - changes freq

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
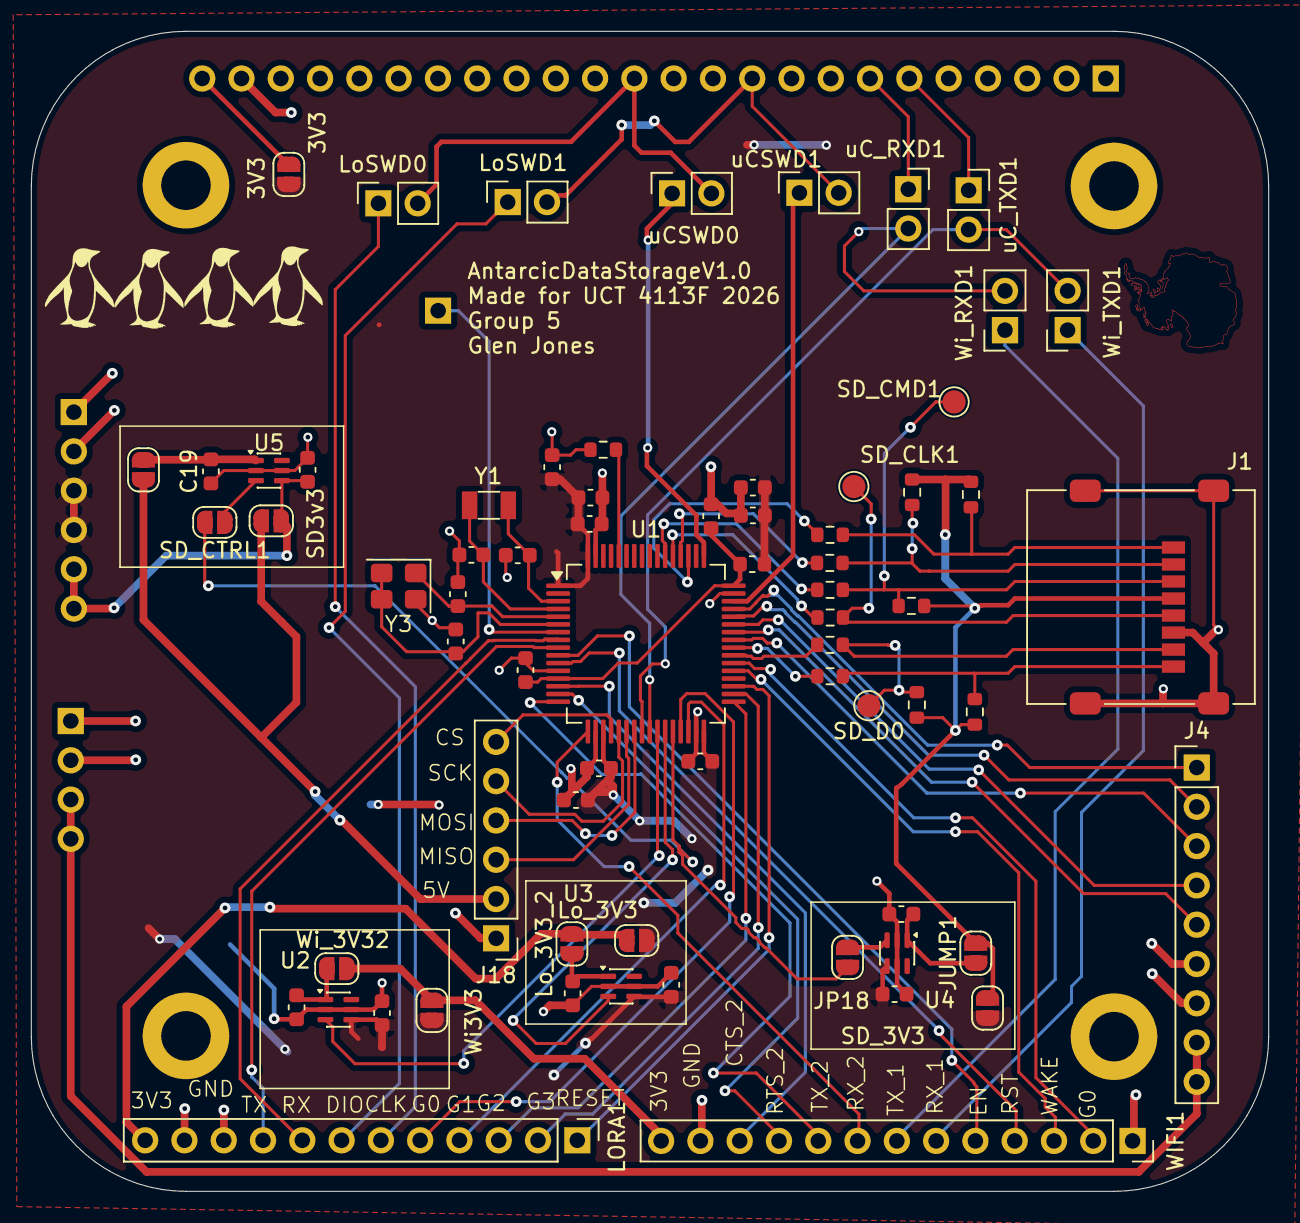
[picture p17: board ComsBoard.kicad_pcb from above]

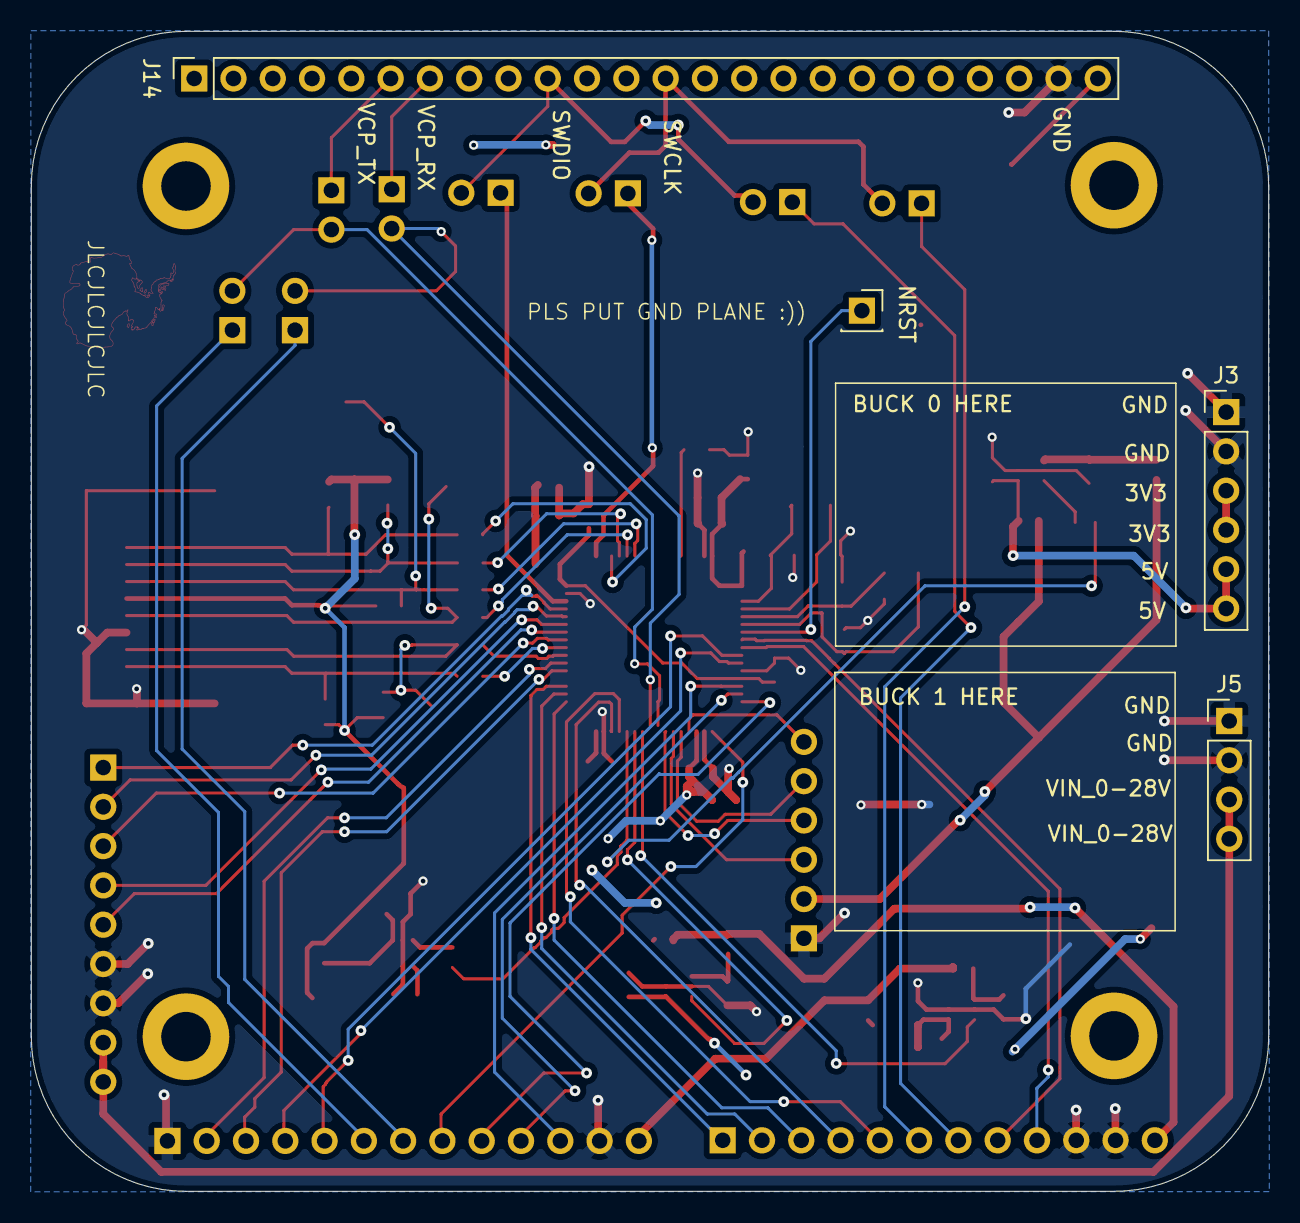
[picture p18: board ComsBoard.kicad_pcb from below]

Board: 2 copper layers, 80.0 x 75.0 mm, 77 parts (4 on the bottom side), 73 nets.

Other parts of the board:
C1#2: 1uF; C_0603_1608Metric
C6: 100nF; C_0603_1608Metric

Their connections:
GND: C1#2.2, C6.2; also elsewhere on the board
