SFBdragon/eee4113f-project/STM32-SW/L4/Core/Inc/main.h

#define UART_DMA_BUF_SIZE  512 // SHARC BUOY INCOMING BUFFER SIZE
#define L0_LPUART1_RX_Pin GPIO_PIN_0
#define L0_LPUART1_RX_GPIO_Port GPIOC
#define L0_LPUART1_TX_Pin GPIO_PIN_1
#define L0_LPUART1_TX_GPIO_Port GPIOC
#define Wi_EN_Pin GPIO_PIN_2
#define Wi_EN_GPIO_Port GPIOC
#define Wi_RST_Pin GPIO_PIN_3
#define Wi_RST_GPIO_Port GPIOC
#define Wi_USART2_TX_Pin GPIO_PIN_2
#define Wi_USART2_TX_GPIO_Port GPIOA
#define Wi_USART2_RX_Pin GPIO_PIN_3
#define Wi_USART2_RX_GPIO_Port GPIOA
#define SD_GPIO_INPUT_Pin GPIO_PIN_4
#define SD_GPIO_INPUT_GPIO_Port GPIOA
#define SD_SPI1_SCK_Pin GPIO_PIN_5
#define SD_SPI1_SCK_GPIO_Port GPIOA
#define SD_SPI1_MISO_Pin GPIO_PIN_6
#define SD_SPI1_MISO_GPIO_Port GPIOA
#define SD_SPI1_MOSI_Pin GPIO_PIN_7
#define SD_SPI1_MOSI_GPIO_Port GPIOA
#define Wi_USART3_TX_Pin GPIO_PIN_4
#define Wi_USART3_TX_GPIO_Port GPIOC
#define Wi_USART3_RX_Pin GPIO_PIN_5
#define Wi_USART3_RX_GPIO_Port GPIOC
#define Wi_PWR_CTRL_Pin GPIO_PIN_0
#define Wi_PWR_CTRL_GPIO_Port GPIOB
#define Lo_PWR_CTRL_Pin GPIO_PIN_1
#define Lo_PWR_CTRL_GPIO_Port GPIOB
#define SD0_PWR_CTRL_Pin GPIO_PIN_2
#define SD0_PWR_CTRL_GPIO_Port GPIOB
#define Lo_GPIO_0_Pin GPIO_PIN_10
#define Lo_GPIO_0_GPIO_Port GPIOB
#define Lo_GPIO_1_Pin GPIO_PIN_11
#define Lo_GPIO_1_GPIO_Port GPIOB
#define Lo_GPIO_2_Pin GPIO_PIN_12
#define Lo_GPIO_2_GPIO_Port GPIOB
#define Wi_WAKE_Pin GPIO_PIN_6
#define Wi_WAKE_GPIO_Port GPIOC
#define Wi_GPIO_0_Pin GPIO_PIN_7
#define Wi_GPIO_0_GPIO_Port GPIOC
#define D_USART_TX_Pin GPIO_PIN_9
#define D_USART_TX_GPIO_Port GPIOA
#define D_USART_RX_Pin GPIO_PIN_10
#define D_USART_RX_GPIO_Port GPIOA
#define D_WAKE_Pin GPIO_PIN_11
#define D_WAKE_GPIO_Port GPIOA
#define D_WAKE_EXTI_IRQn EXTI15_10_IRQn
#define D_GPIO0_Pin GPIO_PIN_12
#define D_GPIO0_GPIO_Port GPIOA
