SFBdragon/eee4113f-project/STM32-SW/L4/Core/Inc/netio.h

// netio.h
//
// Tamryn will write code files to implement parts of this interface.
// e.g. `lora_driver.c` and `wifi_driver.c`
// Shaun will wirete code files to implement parts of this interface.
// e.g. `protocol.c`

#pragma once

#include <stdint.h>


// --------------- Types --------------- //

// See `STATUS_*` constants for semantics.
typedef uint16_t Status;
// The type used to describe buffer lengths.
typedef uint16_t BufLen;

// --------------- Constants --------------- //

// The SX1278 datasheet says that
// Variable-length mode: 0-255 bytes
// Fixed-length mode: 0-2047 bytes
// Unlimited-length mode: 0-? bytes (disables a bunch of features though)
// https://www.alldatasheet.com/datasheet-pdf/download/800241/SEMTECH/SX1278.html
//
// LoRa packets are going to vary considerably in size but be small.
// 64 bytes is enough.
#define MAX_LORA_RECV_PACKET_LEN 250
#define MAX_LORA_SEND_PACKET_LEN 250

#define MAX_WIFI_RECV_PACKET_LEN 506
#define MAX_WIFI_SEND_PACKET_LEN 506

#define STATUS_SUCCESS 0
// add more statusses as necessary

// --------------- LoRa --------------- //

// Read the memory from [data, data + len) bytes and broadcast it via LoRa.
//
// Tamryn defines this function. Shaun calls it.
Status send_lora_packet(uint8_t *data, BufLen len);

// Provide the least recent unread packet in memory [data, data + len).
//
// Shaun defines this function. Tamryn calls it.
// Shaun will avoid having Shaun's error conditions affect Tam's code,
// thus an error code is not returned here.
void recv_lora_packet(uint8_t *data, BufLen len);

// --------------- WiFi --------------- //

Status power_up_wifi();

Status power_down_wifi();

// Read the memory from [data, data + len) bytes and send it off.
//
// Tamryn defines this function. Shaun calls it.
short send_wifi_packet(uint64_t macdst, uint8_t *data, uint16_t len);

// Provide the least recent unread packet in memory [data, data + len).
//
// Shaun defines this function. Tamryn calls it.
// Shaun will avoid having Shaun's error conditions affect Tam's code,
// thus an error code is not returned here.
void recv_wifi_packet(uint64_t *macsrc, uint8_t *data, uint16_t len);
