SFBdragon/eee4113f-project/control-panel/control-gui/build.rs

fn main() {
    let config = slint_build::CompilerConfiguration::new().with_style("fluent-light".into());

    slint_build::compile_with_config("ui/main.slint", config.clone()).expect("Slint build failed");
}
