SFBdragon/eee4113f-project/(commit log)

2026-04-11 laptop drivers: define interface and Rust integration
2026-04-22 add mac addresses to laptop nic driver interface
2026-05-05 Added I2C OLED for debugging
2026-05-05 SDMMC no longer crashing code
    [L4_V3.ioc, main.c, main.h]
2026-05-05 successful non-fail SDMMC init
    [L4_V3.ioc, main.c]
2026-05-07 Fixed wack SDMMC and OLED bug
    [L4_V3.ioc, main.c]
2026-05-07 Flipping into 4-bit mode
    [L4_V3.ioc, main.c]
2026-05-11 Device interrupt Toggle
2026-05-11 Fixed Hardware level SDMMC
    [L4_V3.ioc, main.c]
2026-05-11 SDMCC Test write surviving power cycles
2026-05-12 Fixes RTC and GPIO wake from STOP
    [L4_V3.ioc, main.c, main.h]
2026-05-12 Basic DMA working
2026-05-12 fixed DMA -> SD -> READ SD
    [SD_IO.h, SD_Stream.c, SD_Stream.h, main.c, main.cpp]
2026-05-12 Fixed STOP SDMMC clash
    [L4_V3.ioc, main.c, main.cpp]
2026-05-14 wifi test code
    [desktest.csv, test100m.csv, test10m.csv, test1m.csv, test200m.csv]
2026-05-15 integration testing: implement mock-module, UdpMockRadios, fix protocol.c
    [build.rs, control.h, control_impl.rs, ffi.rs, injector.rs]
2026-05-17 atps: testing, fixes, improvements, add Actions for builds
    [build.rs, colour_bar.rs, control_impl.rs, drivers.h]
2026-05-18 atp test CLI feature, launch error improvements
    [build.rs, main.rs, netio_impl.rs, protocol.c]
2026-05-18 committing Enclosure Subsystem Files
    [ballast_body.stl, ballast_lid.stl, ballast_nut.stl, ballast_screw.stl, component_holder.stl, connector_pod.stl, floatation_Ring.stl, sb_cover.stl]
2026-05-19 Pre-fixing quick lora recieve
    [main.c]
2026-05-20 fix lora send/recv len for esp-now
    [netio.h]
2026-05-20 Fixed reconfigurble LoRa window
    [L4_V3.ioc, SD_Stream.c, SD_Stream.h, control.h, main.c]
2026-05-21 moved some things around and finally got interfaceable wifi firmware
    [desktest.csv, test100m.csv, test10m.csv, test1m.csv, test200m.csv, test202m.csv, test_lora_2km_01m.csv, test_lora_2km_02m.csv]
2026-05-21 Rust wifi serial drivers
2026-05-21 added PCB files
    [ComsBoard.csv, ComsBoard.kicad_pcb, ComsBoard.kicad_sch, EEE4113F_2026_Group_5_JNSGLE007_BOM_EmbeddedSys.csv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]
